githuber-1/infinity-mirror/New_Clock/Design Considerations and BoM.xlsx

Sheet: BoM
System | Component | Description | Quantity | Supplier Link | Price/Unit | Total Price | Own? | Package (in) | In Cart? | Ordered? | Checked Against PCB?
Pro Trinket | Arduino Pro Trinket 5V 16 MHz |  | 1 |  |  |  | Y | NA
 | Header Pins 1x12 (sockets) |  | 2 | https://www.sparkfun.com/products/14321 | 0.5 |  | N | 2.54mm pitch | Y |  | Y
 | Header Pins 1x6 (pins) |  | 1 |  |  |  | Y | 2.54mm pitch
 | FTDI |  | 1 |  |  |  | Y
Misc | SPDT Switch |  | 1 | https://www.mouser.com/ProductDetail/SparkFun/COM-09609?qs=WyAARYrbSnY%2FImRXNY6TIg%3D%3D | 0.75 |  | N |  | Y |  | Y
Misc | Resistor | 220 ohm | 1 | https://www.mouser.com/ProductDetail/Vishay-Dale/CRCW0805220RJNEA?qs=t6Mf8e9K%2FumUMZ356YxxeQ%3D%3D | 0.1 |  | N | 0805 | Y |  | Y
DS1307 | DS1307 RTC | DS1307Z+T&R | 1 | https://www.mouser.com/ProductDetail/Maxim-Integrated/DS1307Z%2bTR?qs=0Y9aZN%252BMVCXp4OQc9xwQow%3D%3D | 3.06 |  | N | 8 SO | Y
 | SM Coin Cell Holder |  | 1 | https://www.mouser.com/ProductDetail/Keystone-Electronics/3001 | 0.43 |  | N
 | Coin Cell CR 1220 | 3V CR1220 | 1 |  |  |  | Y
 | crystal oscillator | Standard 32.768KHz | 1 | https://www.mouser.com/ProductDetail/CTS-Electronic-Components/TFSM262P32K7680?qs=gt1LBUVyoHmNujD19WmIKg%3D%3D | 0.5 |  | N |  | Y
 | 10 Kohm resistor | 10kOhm | 2 | https://www.mouser.com/ProductDetail/Vishay-Dale/CRCW080510K0FKEAC | 0.1 |  | N | 0805 | Y
 | 0.1uF Capacitor | 0.1uF | 1 |  |  |  |  | 0805 |  |  | Y
 | Electret Microphone Max9814 |  |  |  |  |  | Y
 | Resistors | 470 Ohm |  |  |  |  |  | 0805
 |  | 10 kOhm |  |  |  |  | Y | 0805
 |  | 100 kOhm |  |  |  |  |  | 0805
LED | Capacitors | 1000 uF |  |  |  |  | Y
Power, LED | 2 Pin Terminal Block | 2.54mm pitch, Power & LED Cap | 2 | https://www.mouser.com/ProductDetail/SparkFun/PRT-10571?qs=WyAARYrbSnY1iYU5BlBF3w%3D%3D | 0.75 |  | N | 2.54mm pitch |  |  | Y
MSGEQ7 | Chip |  | 1 | https://www.mouser.com/ProductDetail/SparkFun/COM-10468 | 4.95 |  | N |  | Y |  | Y
 | 8 Pin Dip Socket |  | 1 | https://www.mouser.com/ProductDetail/TE-Connectivity/808-AG11D-ESL-LF?qs=IGgAdOvCTsT4AEBBfa5Dhw%3D%3D | 0.93 |  | N |  | Y |  | Y
 | Capacitor | 33 pF | 1 | https://www.mouser.com/ProductDetail/Wurth-Elektronik/885012207128?qs=MLItCLRbWsys1TnbPEYt%252BQ%3D%3D | 0.1 |  | N | 0805 | Y |  | Y
 | Capacitor | 0.1uF | 2 | https://www.mouser.com/ProductDetail/Wurth-Elektronik/885012207128?qs=MLItCLRbWsys1TnbPEYt%252BQ%3D%3D | 0.1 |  | N | 0805 | Y |  | Y
 | Capacitor | 0.01uF | 1 | https://www.mouser.com/ProductDetail/710-885342207005 | 0.1 |  | N | 0805 | Y |  | Y
 | Resistor | 200k | 1 | https://www.mouser.com/ProductDetail/652-CR0805JW-204ELF | 0.1 |  | N | 0805 | Y |  | Y
 | Resistor | 22k | 1 | https://www.mouser.com/ProductDetail/Susumu/RL1220S-R062-F?qs=sGAEpiMZZMvdGkrng054t2rBIJnAoQwe4BjYbebOGMM%3D | 0.05 |  | N | 0805 | Y |  | Y
LED | 3 Pin Terminal Block | LED Power and Data | 1 | https://www.mouser.com/ProductDetail/Adafruit/2136 | 1.25 |  | N | 2.54 mm pitch | Y |  | Y
 | 6 Pin Terminal Block

Sheet: Plan
1. Copy Paste DS1307 Breakout Board Schematic from Sparkfun
 | Check if I can find the crystal oscillator, if not, replace its footprint with one from BoM

Sheet: DS1307 Circuit
 | Clock Chip Datasheet (https://www.mouser.com/datasheet/2/256/DS1307-1513036.pdf) |  | Requirements
 | footprint (https://pdfserv.maximintegrated.com/land_patterns/90-0096.PDF) | oscillator | 32.768k Quartz
 |  |  | Cl 12.5pF
 |  |  | ground fill around x1 x2
X1 is oscillator input
x2 |  |  |  | http://www.learningaboutelectronics.com/Articles/DS1307-real-time-clock-RTC-circuit.php
