githuber-1/infinity-mirror/PCB/infinity_mirror_v0.9.0/BoM_v0.9.0.xlsx

MAIN BOARD
Item | CUST # | Value | Pkg (in) | Qnt | Link | Part Number | Price/Unit | Total Component Price | Owned? | Checked? | Ordered? | Notes
ESP
ESP32-WROOM-32E-N16 | esp1 |  |  | 1 | Mouser (https://www.mouser.com/ProductDetail/356-ESP32WRM32E128PH) | ESP32-WROOM-32E-N16 | $3.60 | $3.60 | Y | y
ESP_EN Pull Up Resistor 10k | esp2 | 10kOhm(1%) | 805 | 1 | Mouser (https://www.mouser.com/ProductDetail/YAGEO/AC0805FR-0710KL) | AC0805FR-0710KL | $0.10 | $0.10 | N | y
ESP_EN Capacitor | esp3 | 1uF/16V(10%) | 805 | 1 | Mouser (https://www.mouser.com/ProductDetail/Samsung-Electro-Mechanics/CL21B105KOFNNNG) | CL21B105KOFNNNG | $0.10 | $0.10 | N | y
ESP 3V3 Filter Cap 0.1uF | esp4 | 0.1uF/50V(10%) | 805 | 1 | Mouser (https://www.mouser.com/ProductDetail/Wurth-Elektronik/885012207098) | 885012207098 | $0.10 | $0.10 | N | y
ESP 3V3 Filter Cap 22uF | esp5 | 22uF/25V(20%) | 805 | 1 | Mouser (https://www.mouser.com/ProductDetail/Samsung-Electro-Mechanics/CL21A226MQQNNWE?qs=yOVawPpwOwnhxyG33uxHJw%3D%3D) | CL21A226MQQNNWE | $0.20 | $0.20 | N | y
POWER
Barrel Jack | pow1 |  | 5.5x2.1mm | 1 | Mouser (https://www.mouser.com/ProductDetail/SparkFun/PRT-10811) | PRT-10811 | $0.95 | $0.95 | N | y
LDO Voltage Regulator | pow2 | 5V -> 3.3V @ > 500mA | SOT223-4 | 1 | Mouser (https://www.mouser.com/ProductDetail/Texas-Instruments/REG1117-33G4?qs=quKhnJqH4FhyowGGftIF6w%3D%3D) | REG1117-3.3G4 | $3.07 | $3.07 | N | y
LDO Cap 0.1uF | pow3 | 0.1uF/50V(10%) | 805 | 2 | Mouser (https://www.mouser.com/ProductDetail/Wurth-Elektronik/885012207098) | 885012207098 | $0.10 | $0.20 | N | y
LDO Cap 10uF | pow4 | 10uF/25V(20%) | 805 | 2 | Mouser (https://www.mouser.com/ProductDetail/Samsung-Electro-Mechanics/CL21A106KAYNNNG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) | CL21A106KAYNNNG | $0.16 | $0.32 | N | y
Power Indicator Current Limiting Resistor | pow5 | 65 Ohm(1%) | 805 | 1 | Mouser (https://www.mouser.com/ProductDetail/YAGEO/RC0805FR-0764R9L) | RC0805FR-0764R9L | $0.10 | $0.10 | N | y
Power Indicator LED | pow6 | RED (2V @ 20mA) | 1206 | 1 | Mouser (https://www.mouser.com/ProductDetail/Wurth-Elektronik/156120RS75000?qs=2kOmHSv6VfTlw4DhG%252BTIQw%3D%3D) | 156120RS75000 | $0.18 | $0.18 | N | y
ADDRESSABLE LEDS
Decoupling Capacitor | led1 | 1000uF | 805 | 1 | Mouser (https://www.mouser.com/ProductDetail/KEMET/ESW108M6R3AH1AA) | ESW108M6R3AH1AA | $0.35 | $0.35 | N | y
Logic Level Shifter | led2 | 3.3 -> 5V | SOT23-3 | 1 | Mouser (https://www.mouser.com/ProductDetail/Micro-Commercial-Components-MCC/BSS138A-TP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) | BSS138A-TP | $0.34 | $0.34 | N | y
Logic Level Resistors | led3 | 10kOhm | 805 | 2 | Mouser (https://www.mouser.com/ProductDetail/YAGEO/AC0805FR-0710KL) | AC0805FR-0710KL | $0.10 | $0.20 | N | y
Right Angle JST, Female and Male | led4 |  |  | 1 | Mouser (https://www.mouser.com/ProductDetail/SparkFun/PRT-09915?qs=WyAARYrbSnY2hwR4tocnvg%3D%3D) | PRT-09915 | $1.50 | $1.50 | N | y
ENCODER
Rotary Encoder Capacitors | enc1 | 0.1uF | 805 | 2 | Mouser (https://www.mouser.com/ProductDetail/Wurth-Elektronik/885012207098) | 885012207098 | $0.10 | $0.20 | N | y
Rotary Encoder w/ 12 Detents + button | enc2 |  | NA | 1 | Mouser (https://www.mouser.com/ProductDetail/Bourns/PEC11R-4320F-S0012?qs=Zq5ylnUbLm5iZFDslE6%2F1w%3D%3D) | PEC11R-4320F-S0012 | $2.16 | $2.16 | N | y
Rotary Encoder Resistors | enc3 | 10kOhm | 805 | 5 | Mouser (https://www.mouser.com/ProductDetail/YAGEO/AC0805FR-0710KL) | AC0805FR-0810KL | $0.10 | $0.50 | N | y
Rotary Encoder Knob | enc4 |  | 6mm shaft | 1 | Mouser (https://www.mouser.com/ProductDetail/SparkFun/COM-10002?qs=WyAARYrbSna9VQZuSb9nNw%3D%3D) | COM-10002 | $1.50 | $1.50 | N | y
PROGRAMMING
Boot / Enable Switches | pro1 | 5.2mm |  | 2 | Mouser (https://www.mouser.com/ProductDetail/SparkFun/COM-08720?qs=WyAARYrbSnaaMDwitZjU3A%3D%3D) | COM-08720 | $0.95 | $1.90 | N | y
Switch Capacitors 0.1uF | pro2 | 0.1 uF/50V(10%) | 805 | 2 | Mouser (https://www.mouser.com/ProductDetail/Wurth-Elektronik/885012207098) | 885012207098 | $0.10 | $0.20 | N | y
Headers | pro3 | 3 pins | 0.1" spacing | 1 | Mouser (https://www.mouser.com/ProductDetail/Amphenol-Commercial-Products/G800W305018EU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) | G800W305018EU | 0.1 | 0.1 | N | y
 |  |  | Total Components | 32 |  |  | Total Price | 17.87
EXTERNAL
Wall Wart to barrel jack | extpow1 | 5V >2.5A | 5.5x2.1mm | 1 | Mouser (https://www.mouser.com/ProductDetail/374-T6634ST) | T6634ST | 6.91 | 6.91 | N
USB to UART Bridge |  |  |  | 1 | Link (https://www.mouser.com/ProductDetail/Silicon-Labs/CP2102N-A02-GQFN24R?qs=u16ybLDytRaIVBf0X4zL0g%3D%3D) | CP2102 (https://www.mouser.com/datasheet/2/368/cp2102n_datasheet-1634912.pdf) |  |  | Y |  |  | Only need 1 total, already have
MECHANICAL HARDWARE
Clock Mounting Screws |  | #6 (0.15") | NA | 2 | McMaster-Carr (https://www.mcmaster.com/drywall-anchors/female-drilling-anchors-with-screw-for-drywall-plaster-and-wood-paneling/)
PCB Mounting Screws |  |  |  |  | McMaster-Carr (https://www.mcmaster.com/wood-screws/screw-size~no-2/length~1-4/)
