githuber-1/infinity-mirror/(list of files, cad)

Other CAD files:
chassis/v0.9.0/chassis_v1.0_printing v17.f3d
chassis/v0.9.0/chassis_v1.0_printing.f3z
