githuber-1/infinity-mirror/PCB/infinity_mirror_v0.9.0/infinity_mirror_v0.9.0.brd

## EAGLE design PCB/infinity_mirror_v0.9.0/infinity_mirror_v0.9.0.brd (2023-05-08)

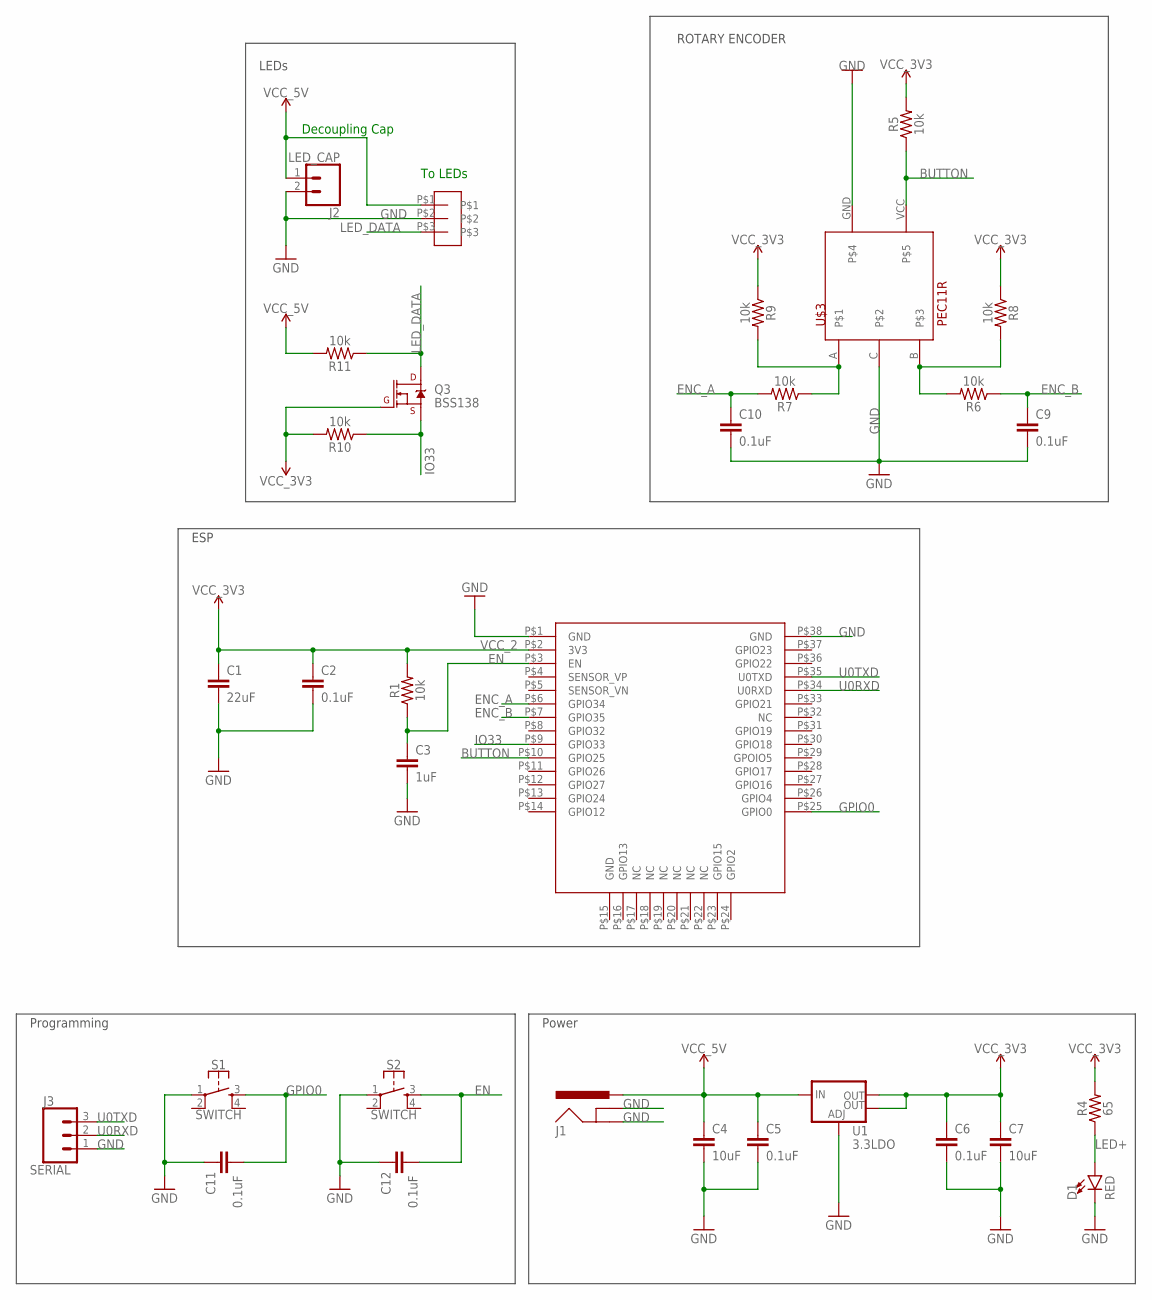
[picture p1: schematic infinity_mirror_v0.9.0.sch]

Parts:
C1: 22uF; 0805
C2, C5, C6, C9, C10, C11, C12: 0.1uF; 0805
C3: 1uF; 0805
C4, C7: 10uF; 0805
D1: RED; LED-1206
J1: POWER_JACKPTH_BREAD; POWER_JACK_PTH_BREAD
J2: LED_CAP; 1X02
J3: SERIAL; 1X03
Q3: BSS138; SOT23-3
R1, R5, R6, R7, R8, R9, R10, R11: 10k; 0805
R4: 65; 0805
S1, S2: SWITCH; TACTILE_SWITCH_SMD_5.2MM
U1: 3.3LDO; SOT223
U$1: ESP32-WROOM-32E
U$2: 3-PIN-JST
U$3: PEC11R; PEC11R-4320F-S0012

Connections:
BUTTON: R5.1, U$1.P$10 (GPIO25), U$3.VCC
EN: C3.1, C12.2, R1.1, S2.3, U$1.P$3 (EN)
ENC_A: C10.1, R7.2, U$1.P$6 (GPIO34)
ENC_B: C9.1, R6.1, U$1.P$7 (GPIO35)
GND: C1.2, C2.2, C3.2, C4.2, C5.2, C6.2, C7.2, C9.2, C10.2, C11.1, C12.1, D1.C, J1.GND, J1.GNDBREAK, J2.2, J3.1, S1.1, S2.1, U1.1 (ADJ), U$1.P$1 (GND), U$1.P$38 (GND), U$2.P$2, U$3.C, U$3.GND
GPIO0: C11.2, S1.3, U$1.P$25 (GPIO0)
IO33: Q3.2 (S), R10.1, U$1.P$9 (GPIO33)
LED+: D1.A, R4.1
LED_DATA: Q3.3 (D), R11.1, U$2.P$3
unnamed: R6.2, R8.2, U$3.B
unnamed: R7.1, R9.2, U$3.A
U0RXD: J3.2, U$1.P$34 (U0RXD)
U0TXD: J3.3, U$1.P$35 (U0TXD)
VCC_1: C4.1, C5.1, J1.PWR, J2.1, R11.2, U1.3 (IN), U$2.P$1
VCC_2: C1.1, C2.1, C6.1, C7.1, Q3.1 (G), R1.2, R4.2, R5.2, R8.1, R9.1, R10.2, U1.2 (OUT), U1.4 (OUT), U$1.P$2 (3V3)

Notes on the sheet:
To LEDs
ROTARY ENCODER
Decoupling Cap
Programming
Power
LEDs
ESP

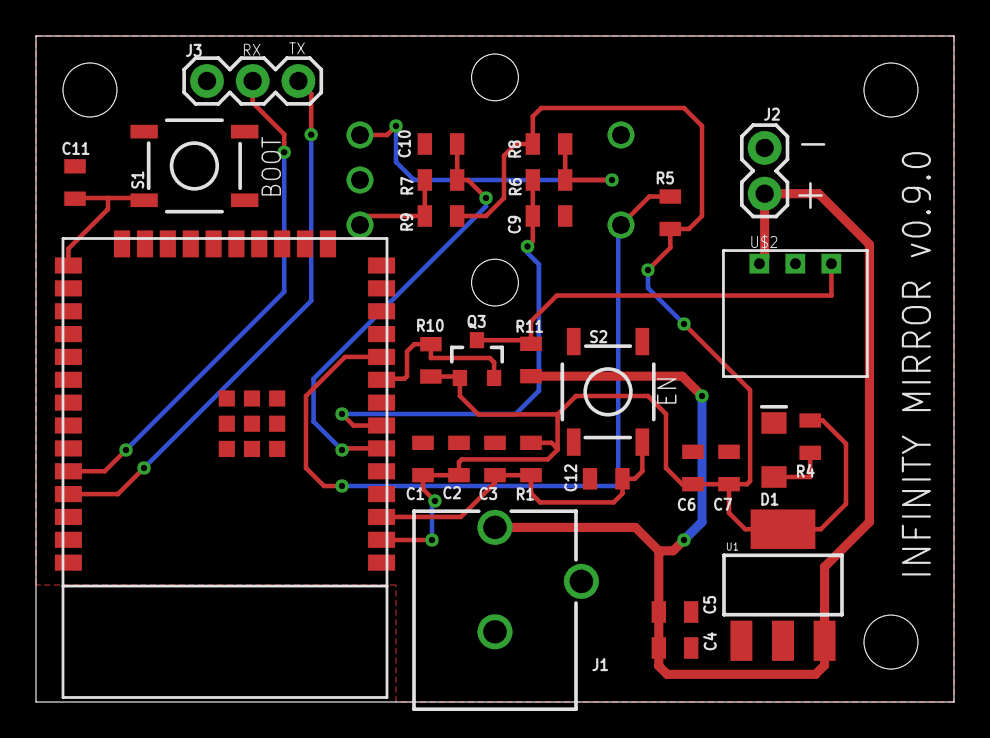
[picture p2: board infinity_mirror_v0.9.0.brd from above]

Board: 2 copper layers, 51.0 x 37.0 mm, 31 parts (1 on the bottom side), 15 nets.
