githuber-1/infinity-mirror/New_Clock/Schematics/a-6-2-2020/Infinity Mirror.brd

## EAGLE design New_Clock/Schematics/a-6-2-2020/Infinity Mirror.brd (2020-06-02)

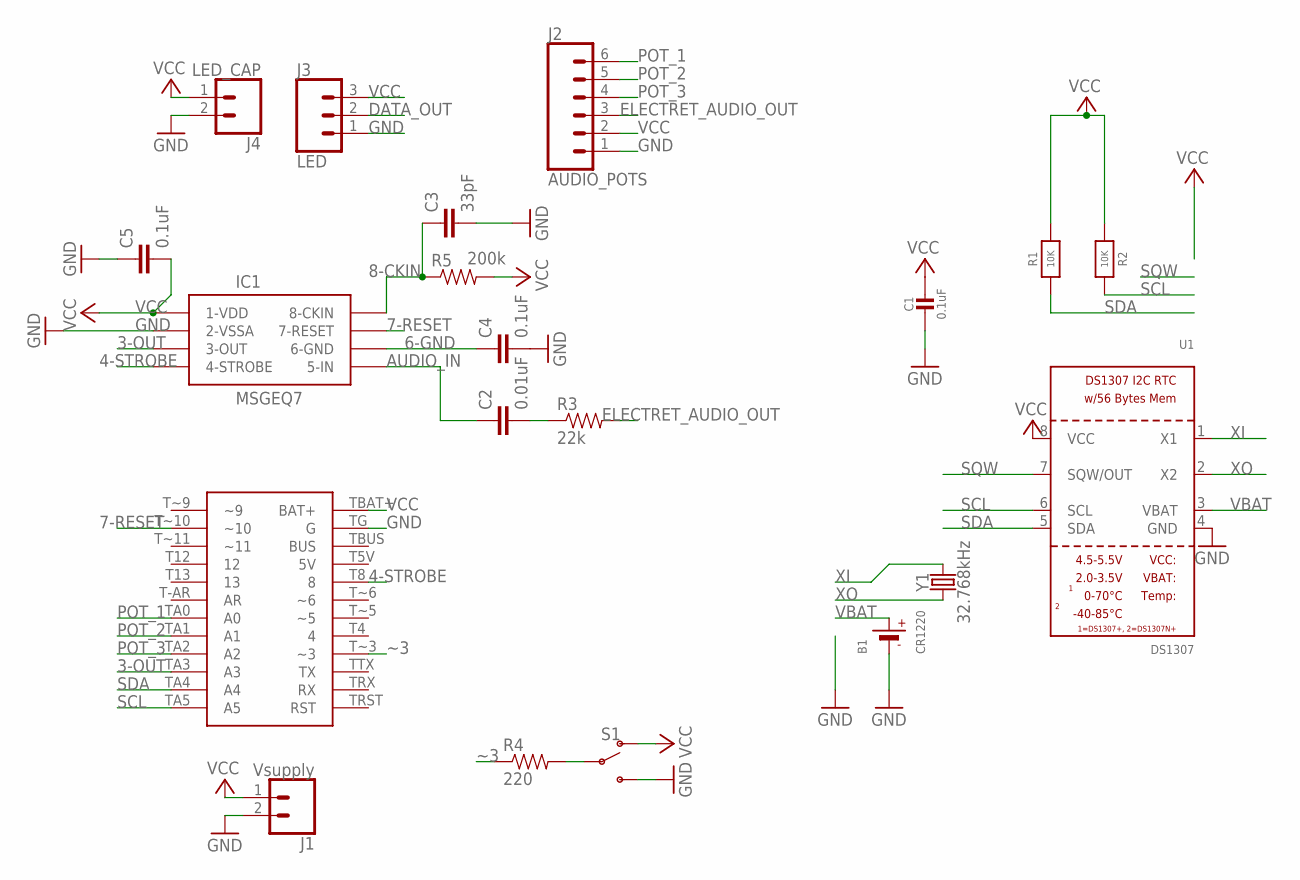
[picture p3: schematic Infinity Mirror.sch]

Parts:
B1: CR1220
C1: 0.1uF; 0805-NO
C2: 0.01uF; SPARKFUN-CAPACITORS_0805
C3: 33pF; 0805
C4, C5: 0.1uF; SPARKFUN-CAPACITORS_0805
IC1: MSGEQ7P; DIP08
J1: Vsupply; SPARKFUN-CONNECTORS_1X02_LOCK
J2: AUDIO_POTS; 1X06
J3: LED; 1X03
J4: LED_CAP; SPARKFUN-CONNECTORS_1X02_LOCK
R1, R2: 10K; 0805-NO
R3: 22k; SPARKFUN-PASSIVES_0805
R4: 220; SPARKFUN-PASSIVES_0805
R5: 200k; SPARKFUN-PASSIVES_0805
S1: SWITCH-SPDT-PTH-11.6X4.0MM-LOCK; SWITCH_SPDT_PTH_11.6X4.0MM_LOCK
U1: DS1307; SOIC8_150MIL
U$1: ADAFRUIT_PRO_TRINKET_NO-DIMENSION; ARDUINO_PRO_TRINKET_5V_NO-DIMENSION
Y1: 32.768kHz; CRYSTAL-PTH-2X6-CYL

Connections:
3: R4.2, S1.2
3-OUT: IC1.3 (3-OUT), U$1.TA3 (A3)
4-STROBE: IC1.4 (4-STROBE), U$1.T8 (8)
6-GND: C4.1, IC1.6 (6-GND)
7-RESET: IC1.7 (7-RESET), U$1.T~10 (~10)
8-CKIN: C3.1, IC1.8 (8-CKIN), R5.1
AUDIO_IN: C2.1, IC1.5 (5-IN)
DATA_OUT: J3.2
ELECTRET_AUDIO_OUT: J2.3, R3.2
GND: B1.-, C1.2, C3.2, C4.2, C5.1, IC1.2 (2-VSSA), J1.2, J2.1, J3.1, J4.2, S1.3 (S), U1.4 (GND), U$1.TG (G)
unnamed: C2.2, R3.1
POT_1: J2.6, U$1.TA0 (A0)
POT_2: J2.5, U$1.TA1 (A1)
POT_3: J2.4, U$1.TA2 (A2)
SCL: R2.2, U1.6 (SCL), U$1.TA5 (A5)
SDA: R1.1, U1.5 (SDA), U$1.TA4 (A4)
SQW: U1.7 (SQW/OUT)
VBAT: B1.+$1 (+), U1.3 (VBAT)
VCC: C1.1, C5.2, IC1.1 (1-VDD), J1.1, J2.2, J3.3, J4.1, R1.2, R2.1, R5.2, S1.1 (O), U1.8 (VCC), U$1.TBAT+ (BAT+)
XI: U1.1 (X1), Y1.2
XO: U1.2 (X2), Y1.1
~3: R4.1, U$1.T~3 (~3)

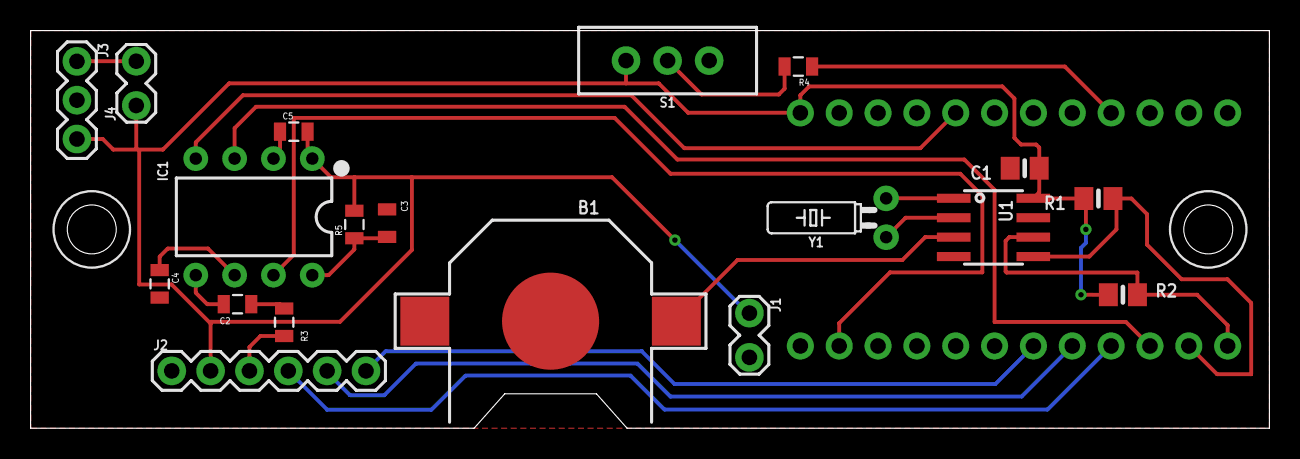
[picture p4: board Infinity Mirror.brd from above]

Board: 2 copper layers, 81.0 x 26.0 mm, 20 parts (0 on the bottom side), 20 nets.
