githuber-1/infinity-mirror/New_Clock/test_code/pythonProject/main.py

import clock
import machine
import neopixel
import time
import pixels
# print('main')
# leds = neopixel.NeoPixel(machine.Pin(13), 60)
# CLOCK = clock.Clock(leds)
# 
# while True:
#     CLOCK.update_leds()
#     time.sleep(0.25)

pixels.RAINBOW()


    
    
    
