githuber-1/infinity-mirror/(commit log)

2020-05-02 old clock folder
    [BoM_JakeandClay.xlsx, Clock_trinketPro.fzz, InfinityClock_BOM.xlsx]
2020-05-02 added trinket and ds1307 to schematic
    [Infinity Mirror.brd, Infinity Mirror.sch, PCB-BoM.xlsx]
2020-05-31 board files almost complete
    [Design Considerations.xlsx, Infinity Mirror.brd, Infinity Mirror.sch, PCB-BoM.xlsx]
2020-06-02 finished pcb rough draft and BoM
    [Design Considerations and BoM.xlsx, Design Considerations.xlsx, Infinity Mirror.brd, Infinity Mirror.sch, InfinityClock_BOM.xlsx]
2020-06-02 fixed errors in infinity mirror draft. This one is ordered, hopefully it works :D
    [Infinity Mirror.brd, Infinity Mirror.sch]
2020-06-22 added test code for board-a proving that the clock, 3 analog inputs, daylight-savings time switch and msgeq7 and leds work
    [Design Considerations and BoM.xlsx, Infinity Mirror.brd, Infinity Mirror.sch, Infinity Mirror_a_Built-6-2-2020.brd, Infinity Mirror_a_Built-6-2-2020.sch, Infinity Mirror_b_unbuilt.brd, Infinity Mirror_b_unbuilt.sch]
2020-06-22 created rec v with a larger board with integrated 8 throw switches. found 3D models and ported circuit box for editing in Fusion. NOTE: THIS CAD IS NOT EXACTLY THE SAME AS THE REAL CLOCK
    [Circuit Box.SLDPRT, Circuit Box.step, DIFFUSION.FACE.SLDPRT, DIFFUSION.PERIMETER.SLDPRT, Final Frame Assembly.SLDASM, Infinity Mirror_b_unbuilt.brd, Infinity Mirror_c_unbuilt.brd, Infinity Mirror_c_unbuilt.sch]
2021-10-25 esp32 devkit c running 60 leds on esp-idf
    [Infinity Mirror.brd, Infinity Mirror.sch, Infinity Mirror_a_Built-6-2-2020.brd, Infinity Mirror_a_Built-6-2-2020.sch, Infinity Mirror_b_unbuilt.brd, Infinity Mirror_b_unbuilt.sch, Infinity Mirror_c_unbuilt.brd, Infinity Mirror_c_unbuilt.sch]
2021-11-11 infinity clock base functionality achieved using ESP32-MINI-1
2021-12-13 added power circuitry to revd
    [infinity_mirror_revd.brd, infinity_mirror_revd.sch]
2021-12-13 restructured directory for clarity
    [BoM_JakeandClay.xlsx, Circuit Box.SLDPRT, Circuit Box.step, Clock_trinketPro.fzz, DIFFUSION.FACE.SLDPRT, DIFFUSION.PERIMETER.SLDPRT, Design Considerations and BoM.xlsx, Final Frame Assembly.SLDASM]
2021-12-20 1st draft schematic and board complete, needs review
    [infinity_mirror_revd.brd, infinity_mirror_revd.sch]
2021-12-20 fixed encoder schematic
    [infinity_mirror_revd.brd, infinity_mirror_revd.sch]
2021-12-21 added logic level shifting for LEDs and buttons for programming
    [infinity_mirror_revd.brd, infinity_mirror_revd.sch, programmer.sch]
2022-01-18 fixed airwires and changed programming header from 6 pins to 4 pins
    [infinity_mirror_revd.brd, infinity_mirror_revd.sch]
2022-01-19 more airwires. cleaned up silk. changed LED cap to leaded electrolytic
    [infinity_mirror_revd.brd, infinity_mirror_revd.sch]
2022-01-21 not sure
    [infinity_mirror_revd.brd, infinity_mirror_revd.sch]
2022-01-26 pcb refactor
    [infinity_mirror_revd.brd, infinity_mirror_revd.sch]
2022-02-23 encoder footprint fix
    [infinity_mirror_reve.brd, infinity_mirror_reve.sch, l1_base_L.stl]
2022-11-28 added b and s temp files and chassis
    [l1_base_b.3mf, l1_base_l.3mf, l1_base_r.3mf, l1_base_t.3mf, l2_leds_bl.3mf, l2_leds_box.3mf, l2_leds_br.3mf, l2_leds_tl.3mf]
2022-12-08 created rev f and g of PCB and rev b of chassis
    [chassis_router.f3d, infinity_mirror_rev_g.brd, infinity_mirror_rev_g.sch, infinity_mirror_revf.brd, infinity_mirror_revf.sch, l1_base_L.stl, l1_base_b.3mf, l1_base_l.3mf]
2022-12-28 serial connector from 4pin to 3pin. changed led data gpio to reduce trace length
    [infinity_mirror_rev_g.brd, infinity_mirror_rev_g.sch]
2023-02-15 rev g purchased
    [infinity_mirror_rev_g.brd]
2023-02-15 added esp32-wroom32e datasheet
2023-05-05 added chassis files / infinity-mirror-sw updates
    [chassis_v1.0_printing v16.step, chassis_v1.0_printing v17.f3d, chassis_v1.0_printing.f3z, layer_one_base_ne.stl, layer_one_base_nw.stl, layer_one_base_se.stl, layer_one_base_sw.stl, layer_three_cap_ne.stl]
2023-05-05 removed ARCHIVE from repo, updated sw peg
    [BoM_JakeandClay.xlsx, Circuit Box.SLDPRT, Circuit Box.step, Clock_trinketPro.fzz, DIFFUSION.FACE.SLDPRT, DIFFUSION.PERIMETER.SLDPRT, Design Considerations and BoM.xlsx, Final Frame Assembly.SLDASM]
2023-05-08 renamed v1.0.0 to v0.9.0, created BoM
    [BoM_v0.9.0.xlsx, infinity_mirror_rev_g.brd, infinity_mirror_rev_g.sch, infinity_mirror_v0.9.0.brd, infinity_mirror_v0.9.0.sch]
2023-05-08 removed pcb backup files
2023-05-08 changed v1.0 to v0.9.0. all chassis files are for printing
    [chassis_v1.0_printing v16.step, chassis_v1.0_printing v17.f3d, chassis_v1.0_printing.f3z, layer_one_base_ne.stl, layer_one_base_nw.stl, layer_one_base_se.stl, layer_one_base_sw.stl, layer_three_cap_ne.stl]
